vonmartins/faderbay/README.md

# FADERBAY

Current Status: Firmware not finnished. 

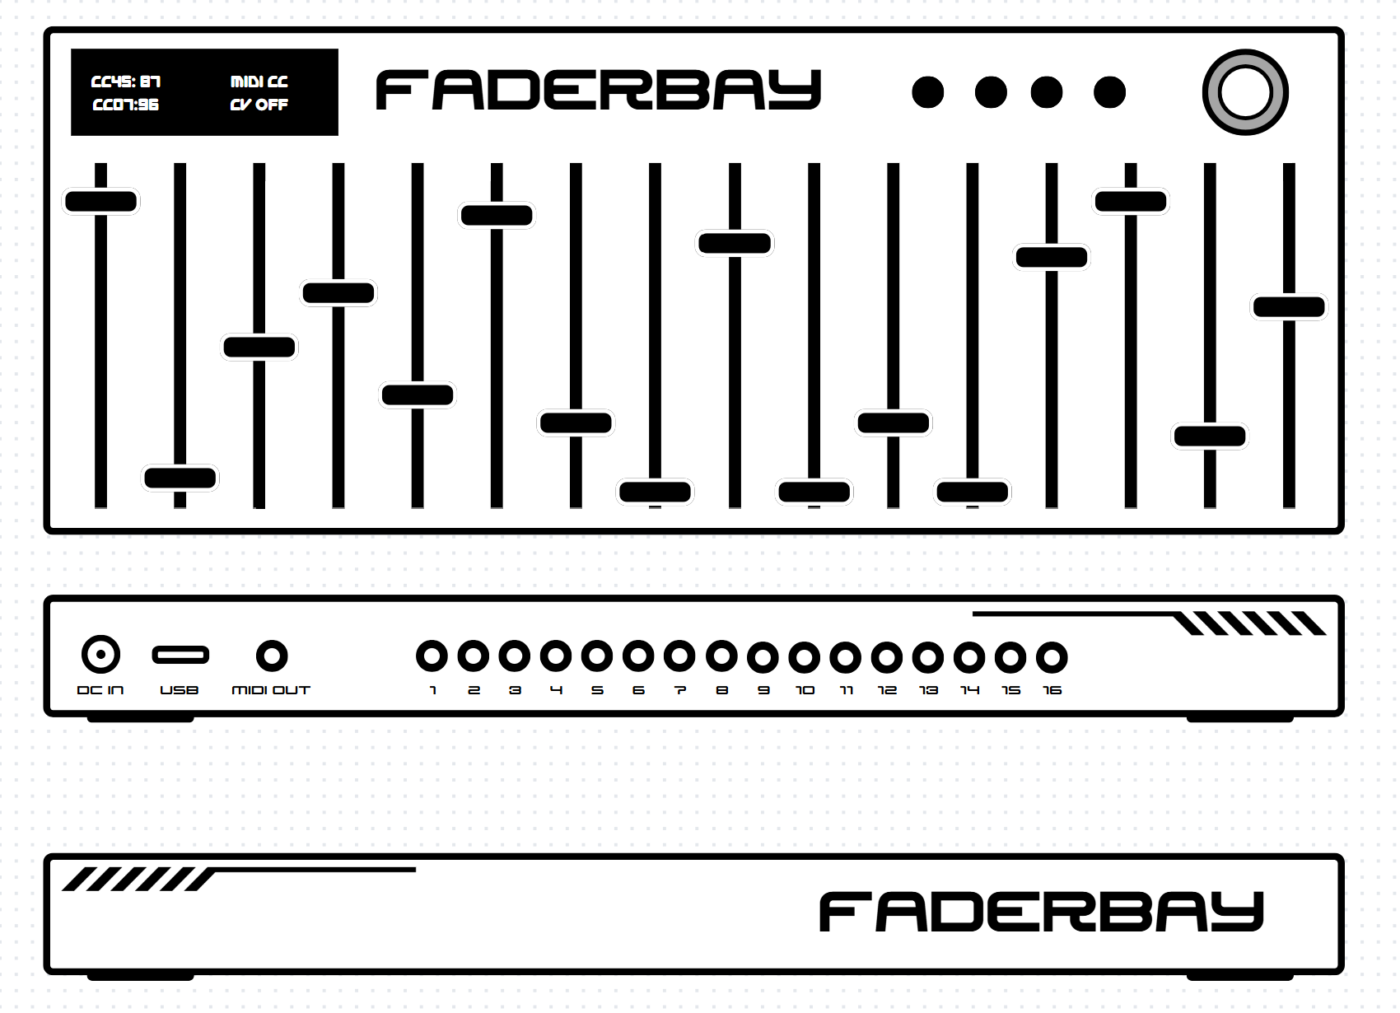
[picture p1: Images/Concept.png]
Concept


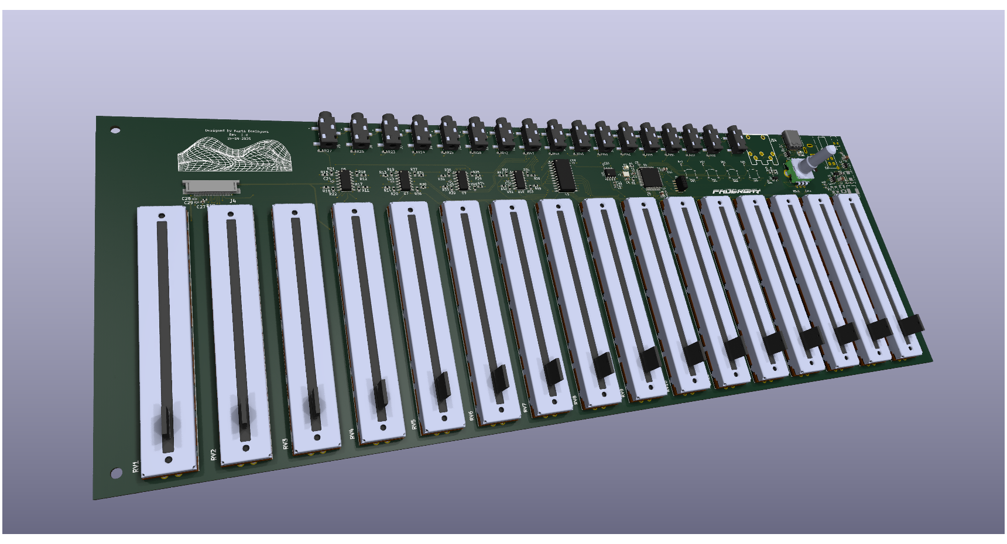
[picture p2: Images/Faderbay1.png]
im1

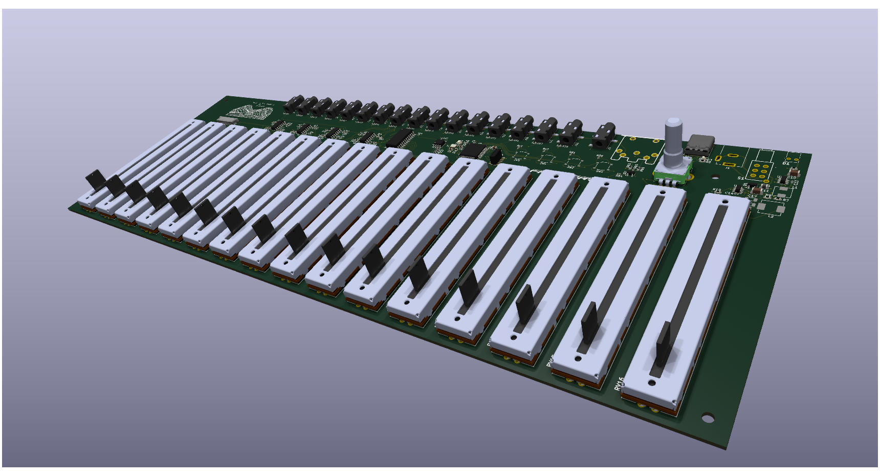
[picture p3: Images/Faderbay2.png]
im2

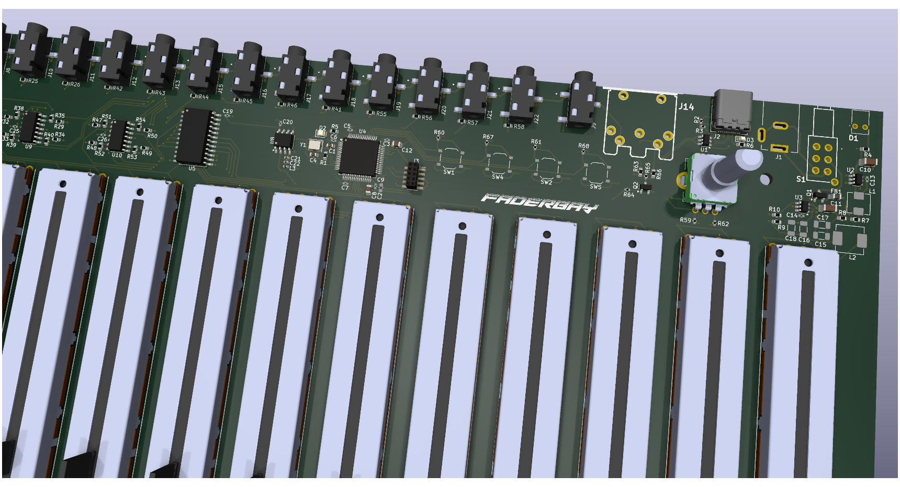
[picture p4: Images/Faderbay3.png]
im3

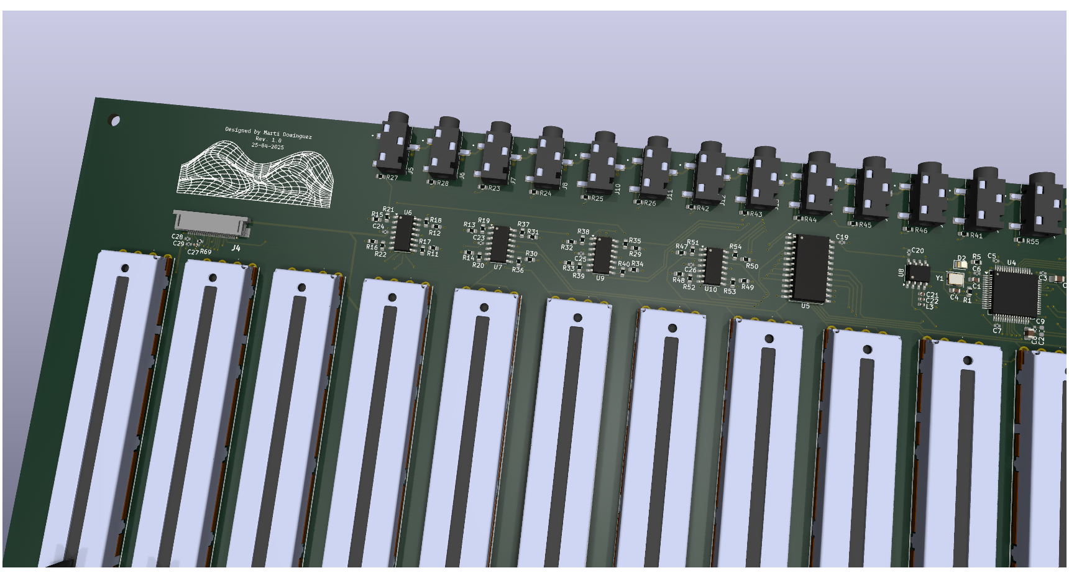
[picture p5: Images/Faderbay4.png]
im4
