vonmartins/faderbay/Legacy/Firmware/README.md

# Firmware

Currently under development.
