vonmartins/faderbay/Documentation/faderbay/resources/image_0_0.jpg

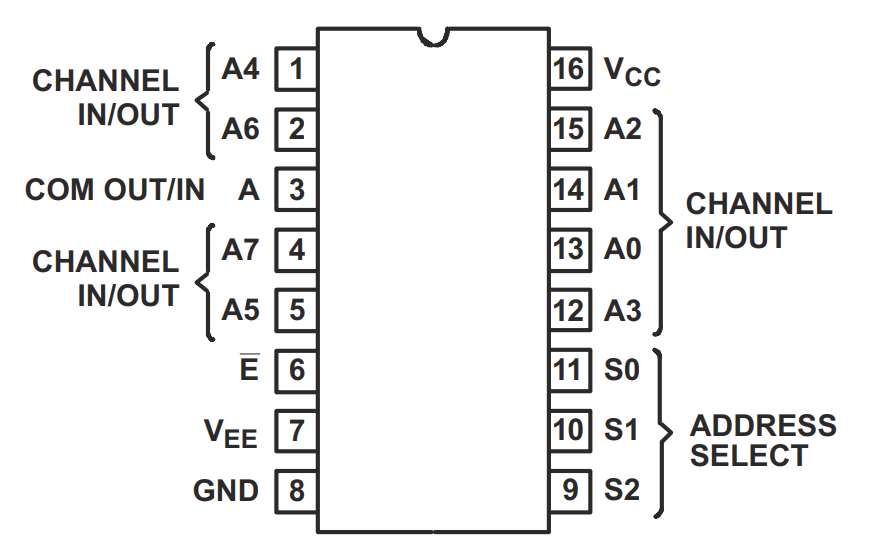
Documentation/faderbay/resources/image_0_0.jpg
