vonmartins/faderbay/Documentation/faderbay/resources/image_1418980290_0.jpg

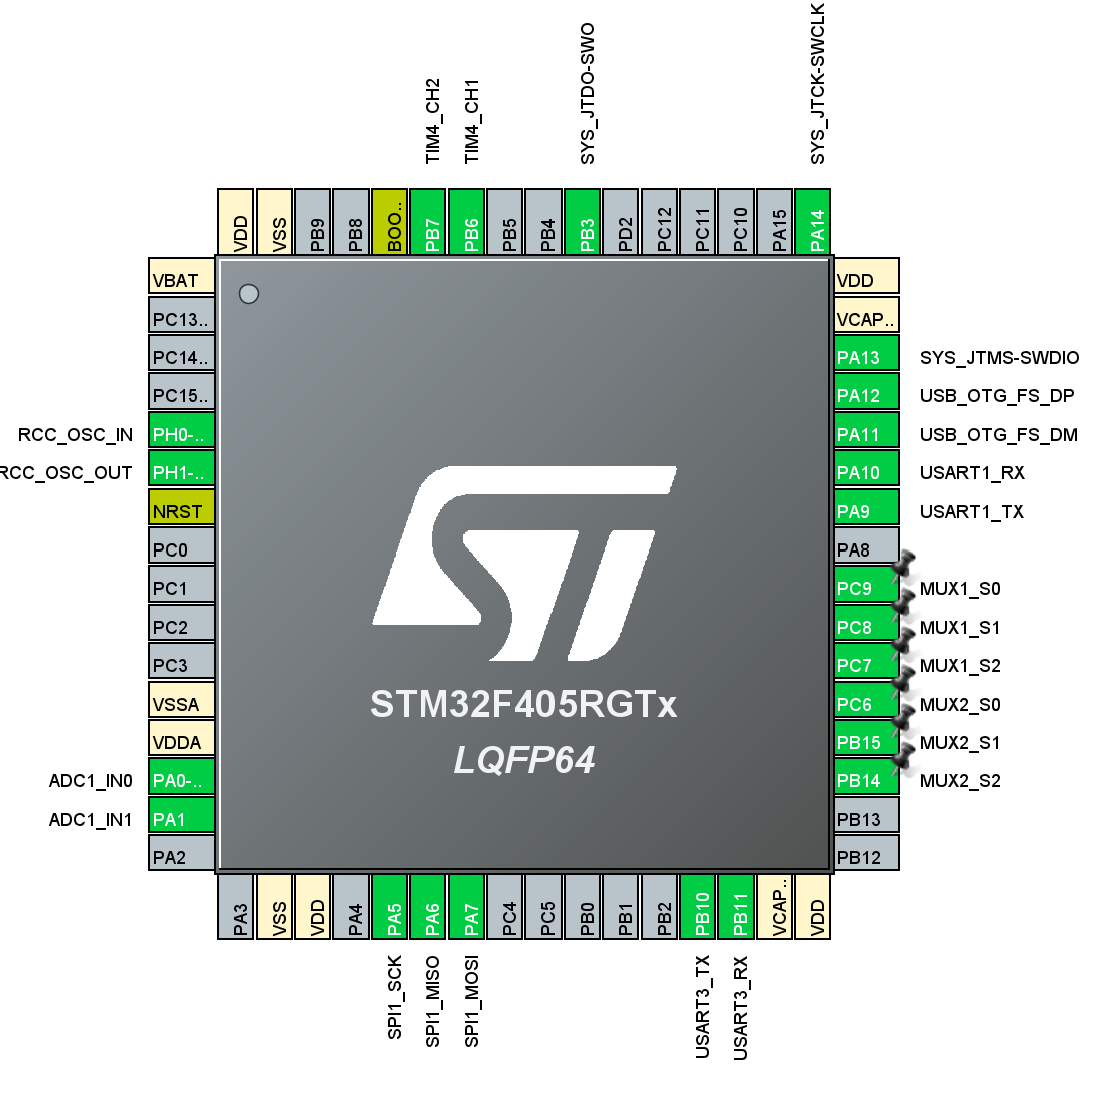
Documentation/faderbay/resources/image_1418980290_0.jpg
