vonmartins/faderbay/Images/esquema_0.png

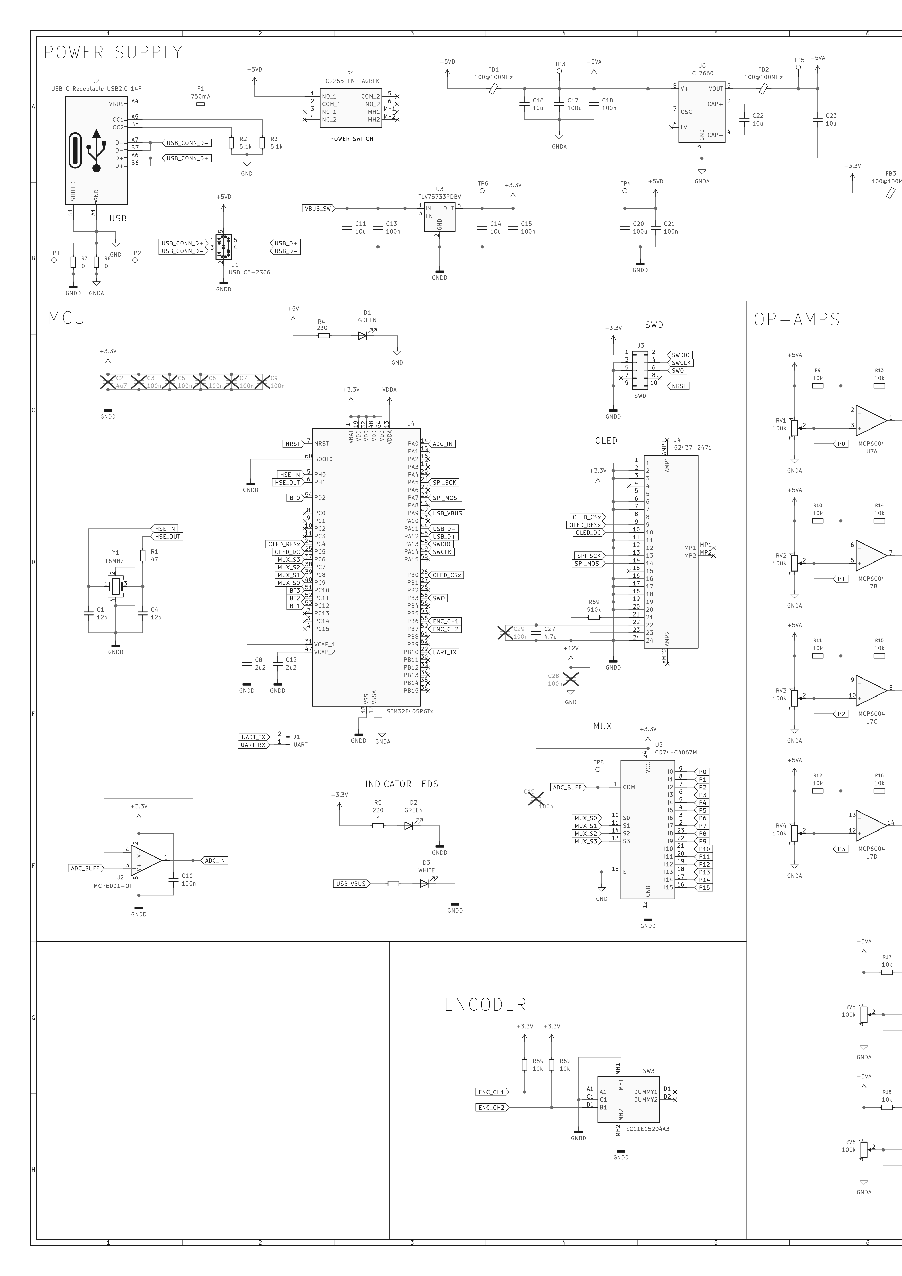
Images/esquema_0.png
