vonmartins/faderbay/Images/esquema_1.png

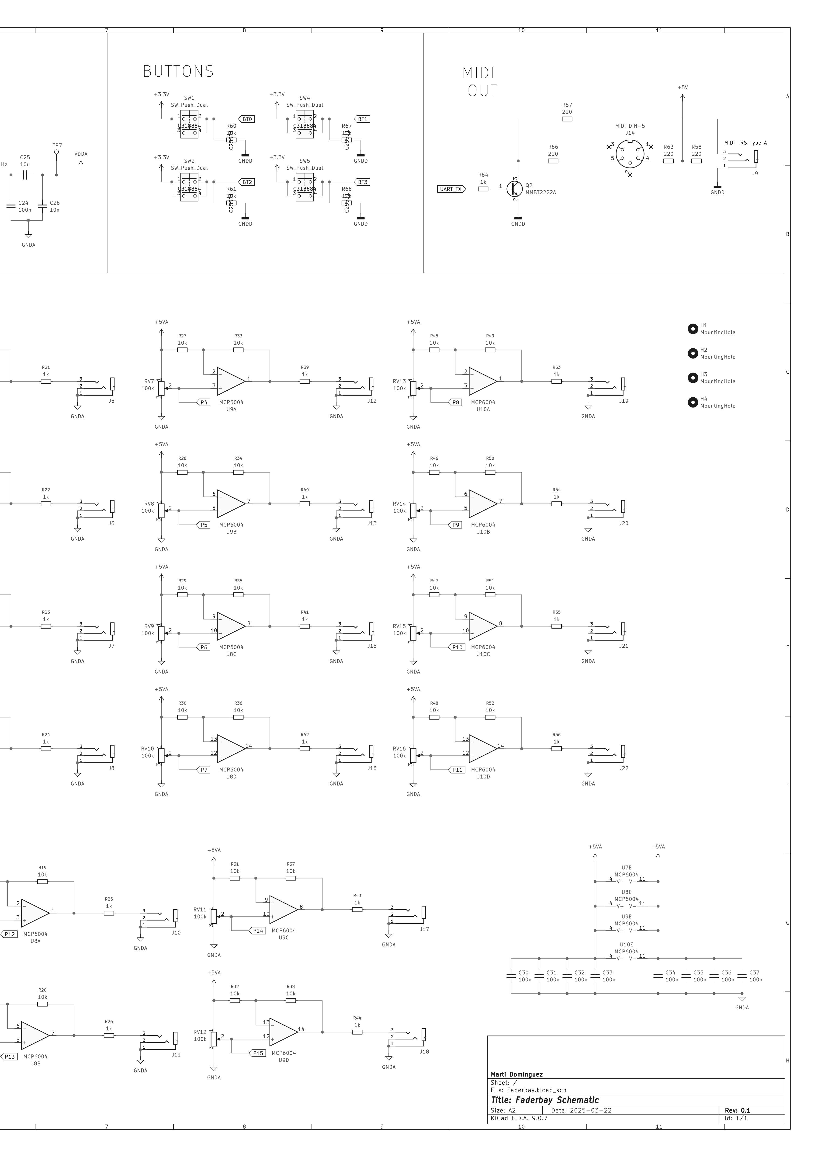
Images/esquema_1.png
