vonmartins/faderbay/Images/Gemini_Generated_Image_xs4kx1xs4kx1xs4k.png

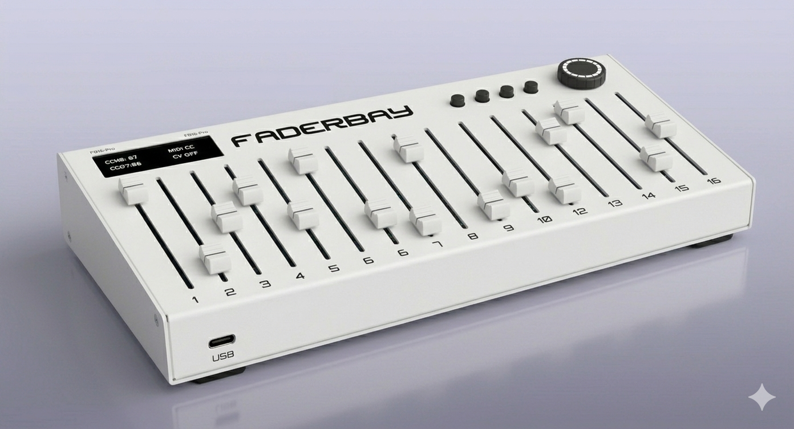
Images/Gemini_Generated_Image_xs4kx1xs4kx1xs4k.png
