vonmartins/faderbay/Images/Models.png

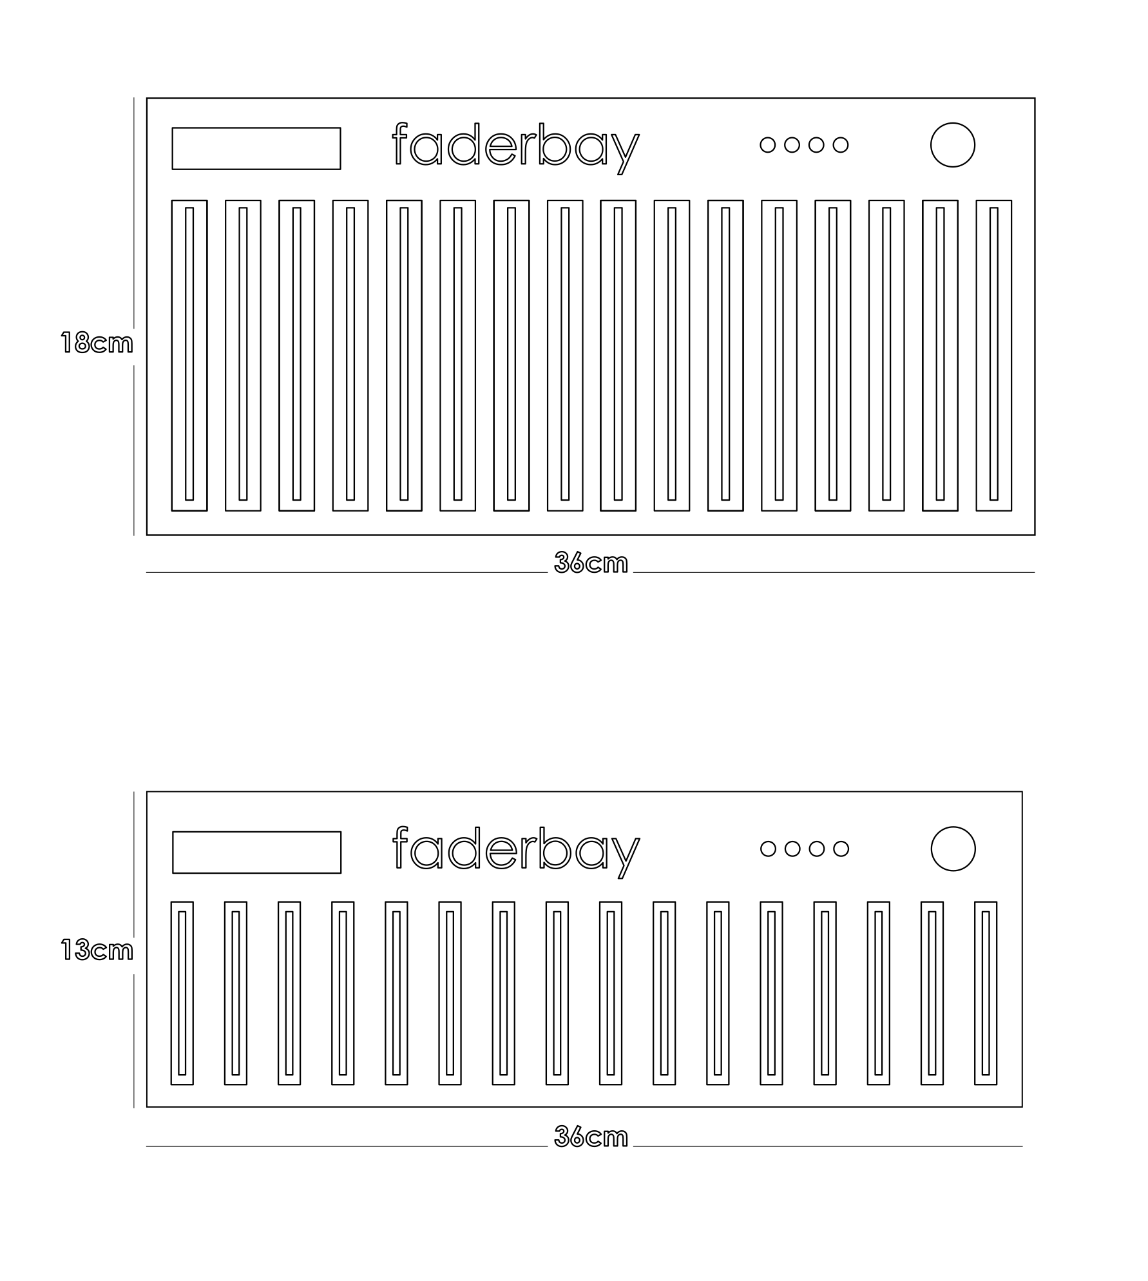
Images/Models.png
