vonmartins/faderbay/Documentation/faderbay.xlsx

Sheet: Caracteristicas
I/O
16 Faders (2MUX) | adc y gpio | MUX
4 Botones | gpio | Enh
16 Minijacks CV |  | COM
1 Minijack MIDI | uart | S0
1 USB - C | usb | S1
1 DC Input |  | S2
1 Encoder | timer
OLED Screen | spi
Midi DIN5 | uart
CARACTERISTICAS
CV Output Change Range | 0-10V and -5-5V
Save configurations | Flash
Set off/on specific CVs
Add Faders Module Expansion

Sheet: HOJA DE RUTA
HOJA DE RUTA
Descripción | Categoria | Prioridad | Estado | Progreso | Comentarios
Hacer Esquema Circuito | Hardware, Diseño | Alta | En progreso |  | EasyEDA. Mirar 16n
Mirar código EEPROM | Software | Baja | Finalizado |  | Mirar como hacer codigo para guardar en la memoria
Pensar MCU | Pensar, Hardware | Alta | Finalizado | STM32F405RGT | Que MCU usar. Con ADC. Teensy, stm32
Plantear estructura código | Software | Alta | Finalizado |  | Que librerias, estructuras, lógica general, etc
Selección de faders | Hardware, Pensar, Compra | Media | Finalizado | PTB0143-2010BPA103 | De buena calidad, lineal/log. 10 cm
Selección de pantalla OLED | Hardware, Pensar, Compra | Media | No empezado |  | I2C/SPI
Prototipo PCB | Diseño, Hardware | Baja | No empezado
Leer faders | Software | Media | En progreso |  | Uso de multiplexores
Lógica selección de modos | Software | Baja | No empezado |  | MIDI/CV/Ambos
Hacer GUI para la tft | Diseño | Baja | No empezado
Probar que resistencia ponerle al LED del fader | Hardware | Media | No empezado |  | 150, 180 o 220 ohms
start stm32cubeide project | Software | Alta | Finalizado | Hecho con VSCode
start with UI interfaces (faders, buttons, encoder) | Software | Media | En progreso
code device struct | Software | Media | En progreso
poll UI to change device settings | Software | Media | En progreso | Mirar lectura faders ya que parece que lee mal. Mapear el valor antes de comprobar si hay cambio?
Read and write memory to save configs | Software | Alta | En progreso | NO FUNCIONA. Comprobar funcion Write
MIDI Interface | Software | Media | En progreso | Comprobar | Use library? UART
MIDI Device | Software | Media | En progreso | No funciona sin oscilador de cristal o HSE? | https://github.com/Hypnotriod/midi-box-stm32/tree/master
Código OLED | Software | Media | No empezado
Implement CLI | Software | Media | Finalizado
Hacer gestion de errores | Software | Alta | Finalizado
USB Device change descriptor at cubeMX | Software | Baja | No empezado
mirar con osciloscopio si hace falta debouncing con condensadores en los botones | Hardware | Media | En progreso | Lo hago desde sfotware?
mirar osciloscopio si hacer pull up en el encoder | Hardware | Media | Finalizado | Si
Diseñar interruptor del cricuito | Hardware | Alta | En progreso |  | Se junta con el BOOT0?
Diseñar footprints faltantes | Hardware, Diseño | Alta | No empezado | Fader, encoder
Encontrar pushbutton power | Hardware | Alta | En progreso

Sheet: Copia de Hoja 2
PRODUCTO | REF | DESCRIPCIÓN | PARTE | CANTIDAD | PRECIO | TOTAL | LINK
Fader | RS6011SP6003 | 60mm / 10k |  | 16 | 4.68 € | 74.88 € | https://www.mouser.es/ProductDetail/Alps-Alpine/RS6011SP6003?qs=3cOf6TWd2rbyy41GF81woQ%3D%3D
Fader | PTL60-15O1-104B2 | 60mm / 100k |  | 16 | 2.65 € | 42.40 € | https://www.mouser.es/ProductDetail/Bourns/PTL60-15O1-104B2?qs=nAEW9fCjKd9VkMEfC2OFmQ%3D%3D
 |  |  |  |  |  | 0.00 €
Teensy 4.0 | TEENSY40 |  |  | 1 | 21.70 € | 21.70 € | https://www.pjrc.com/store/teensy40.html
Midi Conector | 485-1134 |  |  |  | 1.65 € |  | https://www.mouser.es/ProductDetail/Adafruit/1134?qs=GURawfaeGuCcC0%252BrNLxslQ%3D%3D
Multiplexor 8 ch | 74HC4051D | Multiplexor de 8 canales |  |  | 0.46 € |  | https://www.mouser.es/ProductDetail/Toshiba/74HC4051D
OP-Amp | MCP6004_SMD | Quad opamp |  |  | 0.51 € |  | https://www.mouser.es/ProductDetail/Microchip-Technology/MCP6004-I-SL?qs=n%2FfJlMG9rCZ2%2F%2FCryvZ52w%3D%3D
Mini jack hembra |  | 10 unidades |  |  | 1.66 € |  | https://m.es.aliexpress.com/item/32766726918.html
Conector USB-C | https://es.aliexpress.com/item/1005005187689195.html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
Power LED | https://www.mouser.es/ProductDetail/Kingbright/WP934EW-GD?qs=58z0TXQGVSTZ3lOkUk8wEA%3D%3D
OLED | https://newhavendisplay.com/es/3-m%C3%B3dulo-oled-gr%C3%A1fico-blanco-de-12-pulgadas/ | https://shop.lcd-module.com/search?search=W256064-XA |  |  |  | https://newhavendisplay.com/es/3-m%C3%B3dulo-oled-gr%C3%A1fico-blanco-de-12-pulgadas/
Barrel Jack DC | https://www.digikey.es/es/products/detail/kycon-inc/KLDX-0202-A/9975992?productid=9975992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
SMD LED | https://jlcpcb.com/partdetail/Xinglight-XL_1608PGC06/C7371905
USB-C Conn | https://jlcpcb.com/partdetail/AmphenolIcc-12401610E42A/C5119948
Jacks | https://jlcpcb.com/partdetail/19296-PJ_320BSurfaceMount/C18594 | https://www.mouser.es/ProductDetail/Amphenol-FCI/10038075-A1PLF?qs=LmzVcvYPptTR2f1ldRPXug%3D%3D
MIDI Conn
Inductor 0402 | https://jlcpcb.com/partdetail/Sunlord-SDCL1005C39NJTDF/C26443
Power inductor | https://jlcpcb.com/partdetail/188641-FXL0530_6R8M/C177249
Cristal OSC | X322516MLB4Sl
Mom Switch | https://www.mouser.es/ProductDetail/Wurth-Elektronik/430182070816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
Switch ON/Off | https://www.mouser.es/ProductDetail/Alpha-Taiwan/SP70030F-0202-13F1-01-NN?qs=yA6kp8fx8Y48L6RofibbJA%3D%3D

Sheet: Hoja 4
Current consumption
 | # | Voltage | Amps/unit | Total
MCU | 1 | 3v3 | 0.120 | 0.12
MUX | 1 | 3v3 | 0.008 | 0.008
MCP6004 | 4 | 3v3 | 0 | 0
Total 3.3V |  |  |  | 128 | mA
TL074 | 4 | 12 | 0.0025 | 0.01
OLED Panel | 1 | 12 | 0.055 | 0.055 | Jumper option 2 | https://newhavendisplay.com/es/3-m%C3%B3dulo-oled-gr%C3%A1fico-blanco-de-12-pulgadas/
Total 12V |  |  |  | 65 | mA
Total |  |  |  | 193 | mA
