vonmartins/faderbay/Hardware/Kicad/rev0.1/pta6043-2x10cixxxx.stp

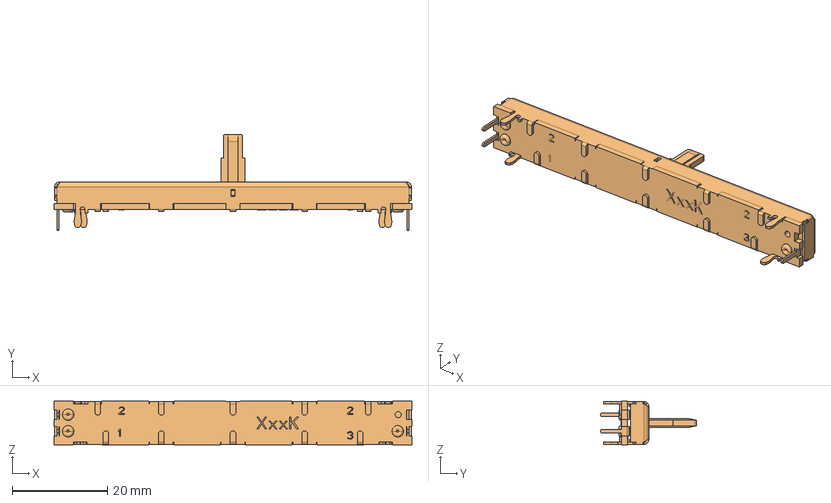
[picture p12: CAD file, 2026-05-17]
Hardware/Kicad/rev0.1/pta6043-2x10cixxxx.stp
75.2 x 20.2 x 9.20 mm
