vonmartins/faderbay/(list of files, drawings)

Other design files:
Hardware/Kicad/rev0.1/Faderbay.dsn
