vonmartins/faderbay/Hardware/Kicad/rev0.1/Faderbay.kicad_pcb

## KiCad design Hardware/Kicad/rev0.1/Faderbay.kicad_pcb (2026-05-23)

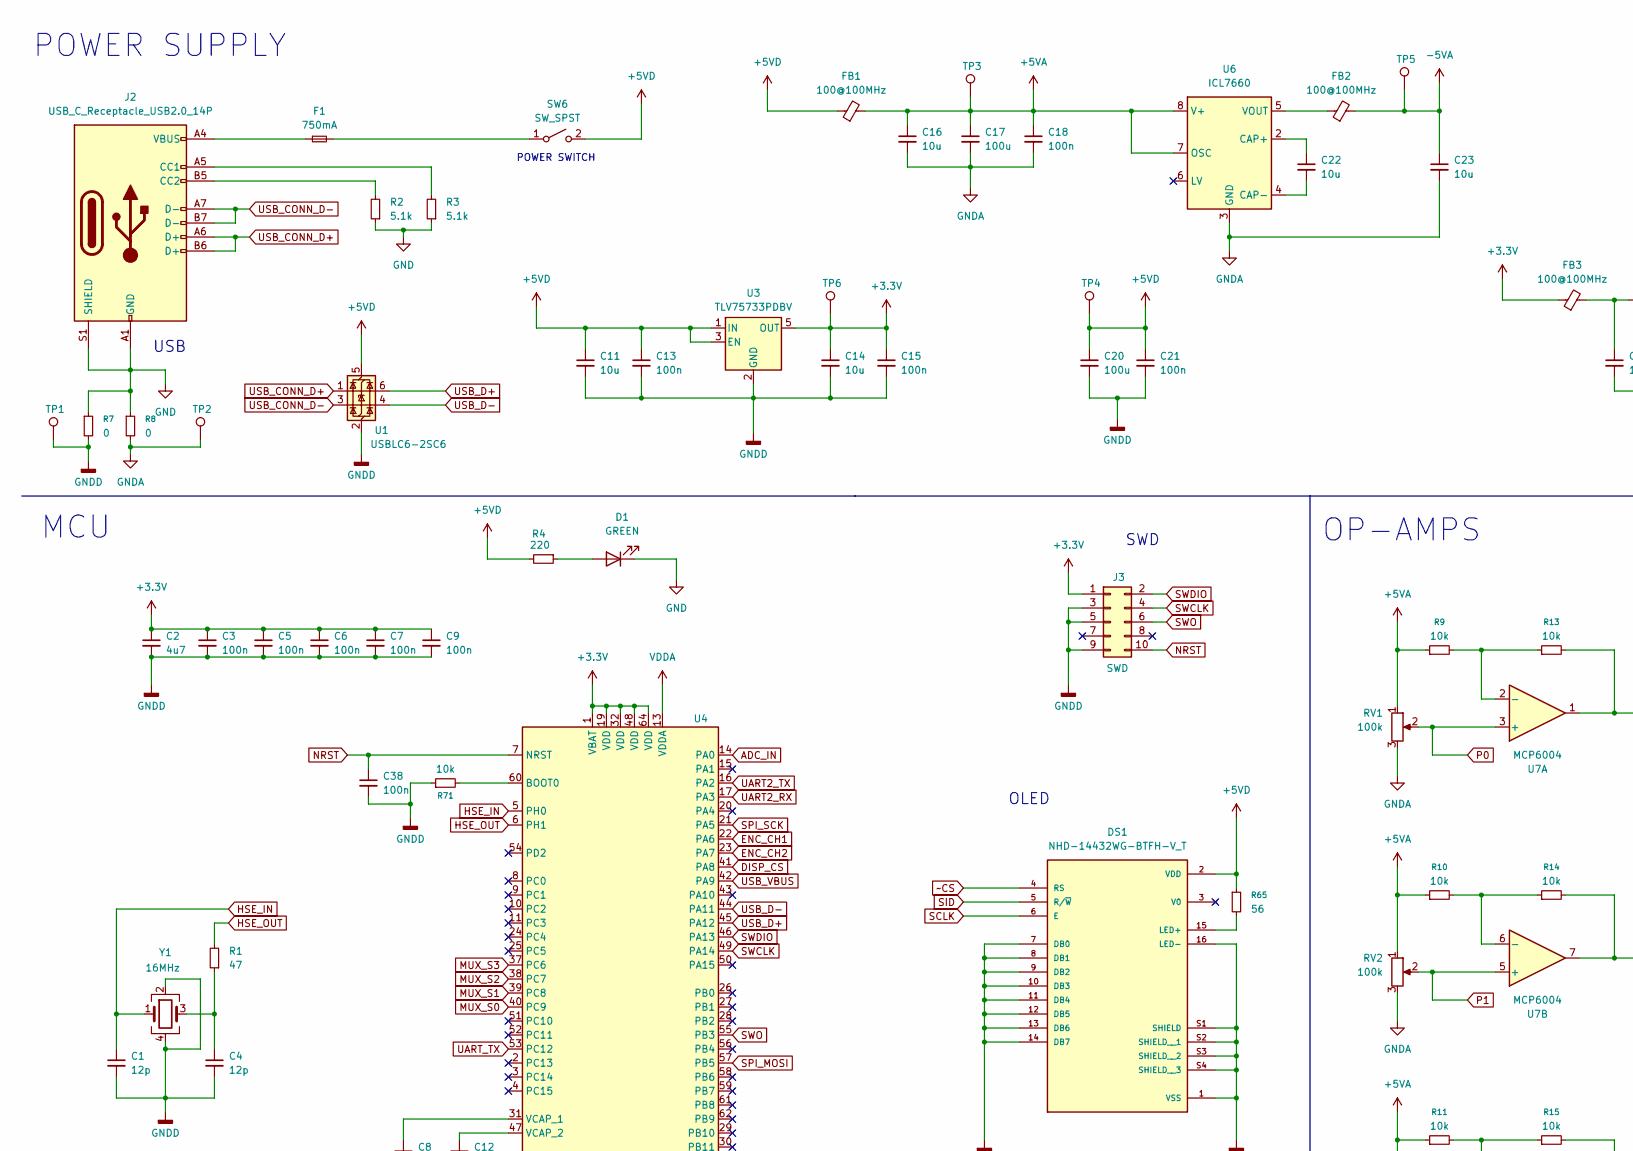
[picture p13: schematic Faderbay.kicad_sch, Faderbay Schematic, part in row 1, column 1]

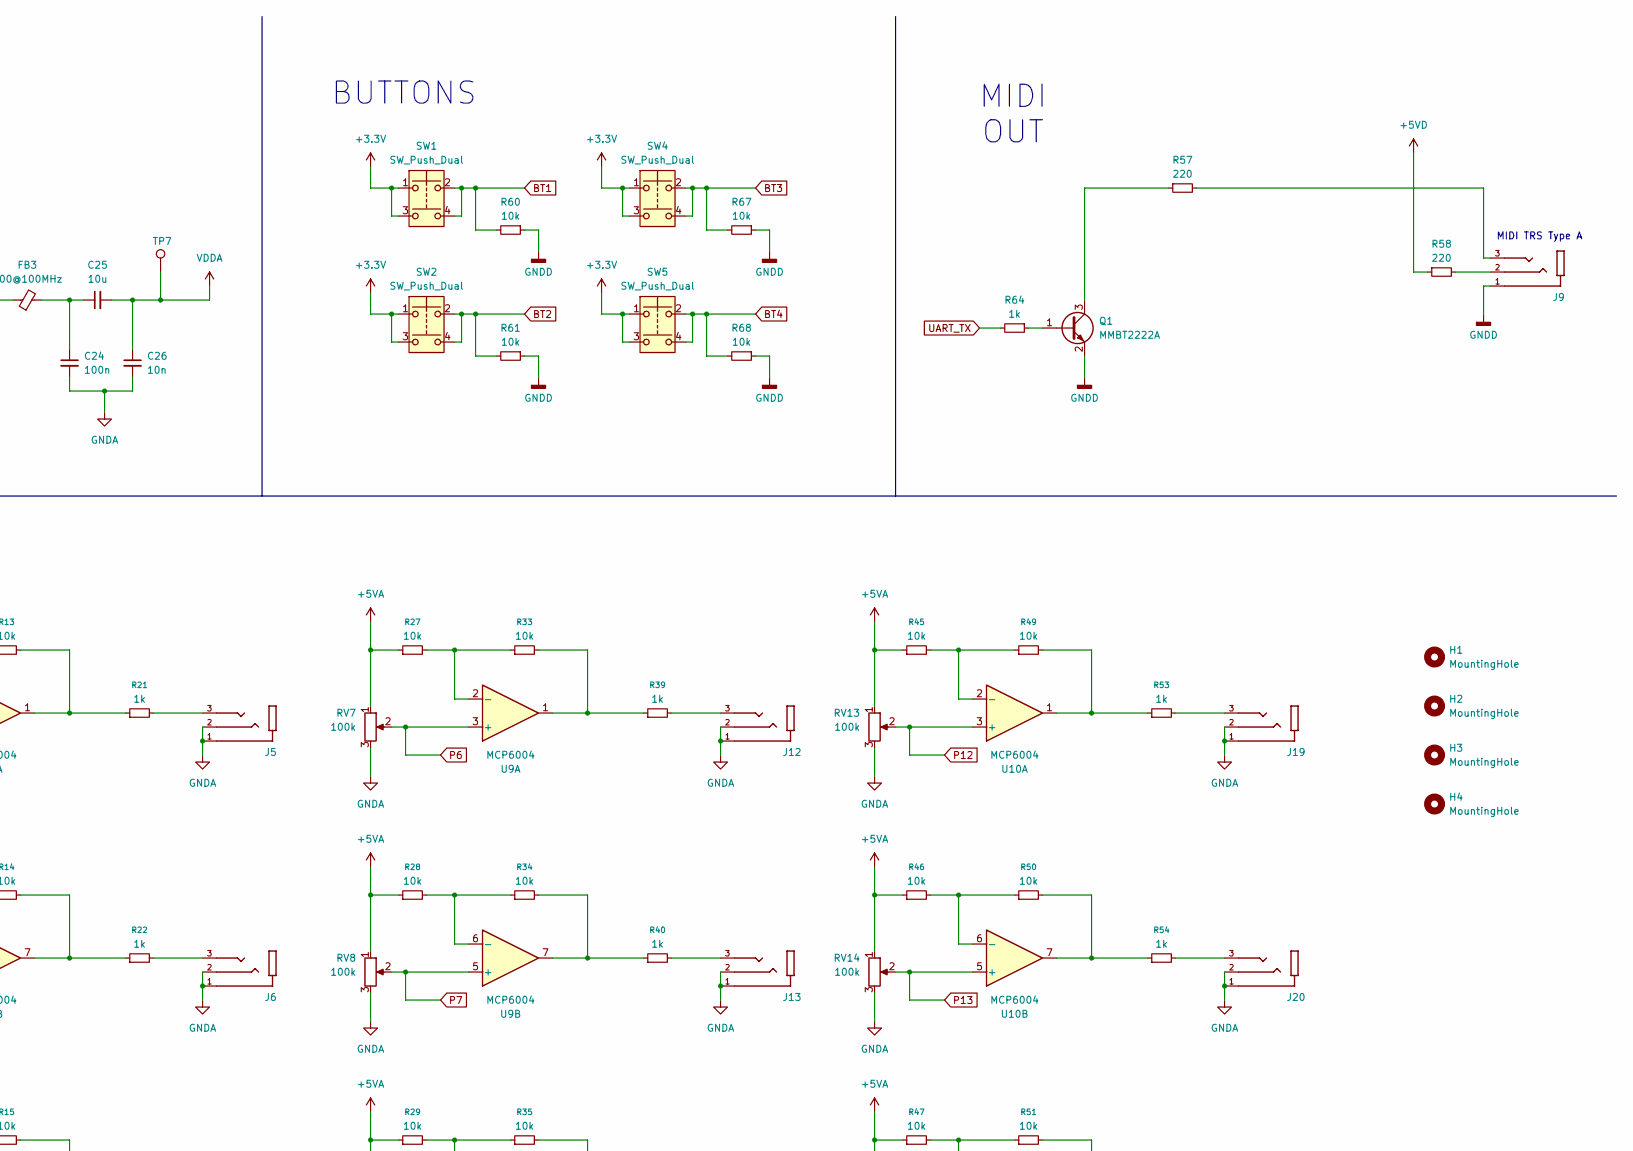
[picture p14: schematic Faderbay.kicad_sch, Faderbay Schematic, part in row 1, column 2]

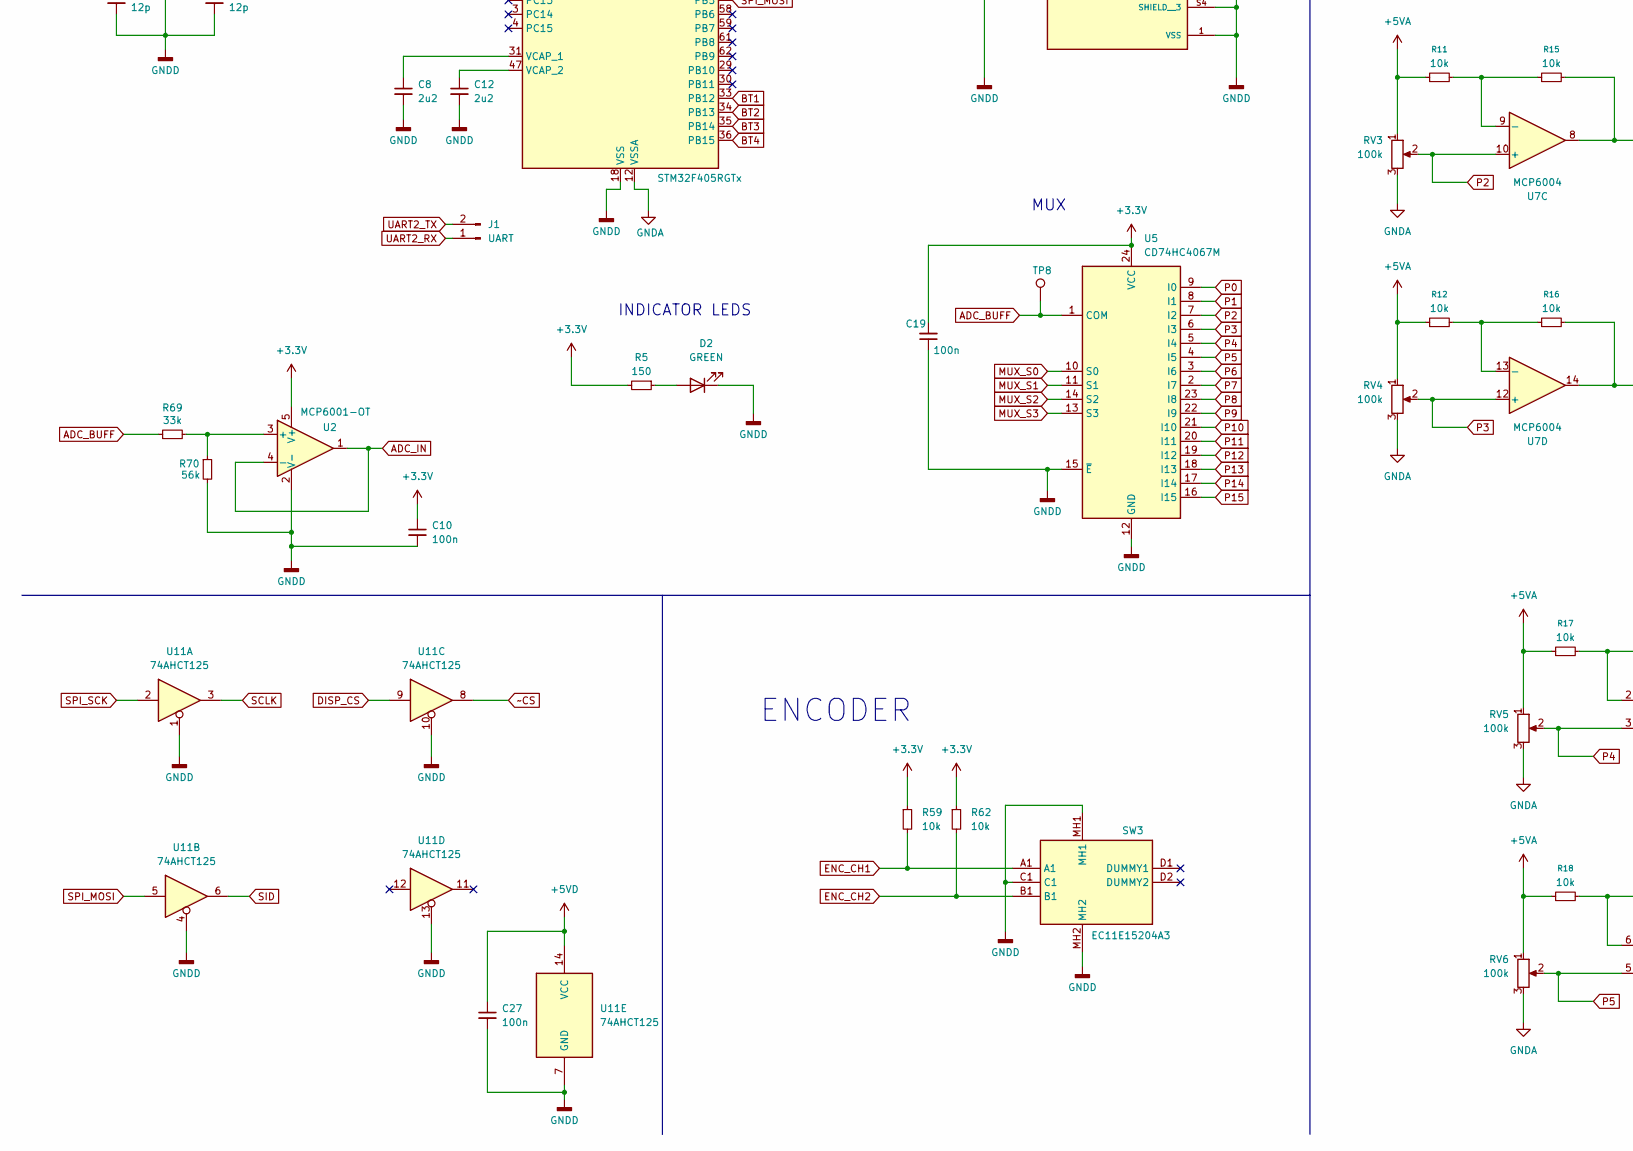
[picture p15: schematic Faderbay.kicad_sch, Faderbay Schematic, part in row 2, column 1]

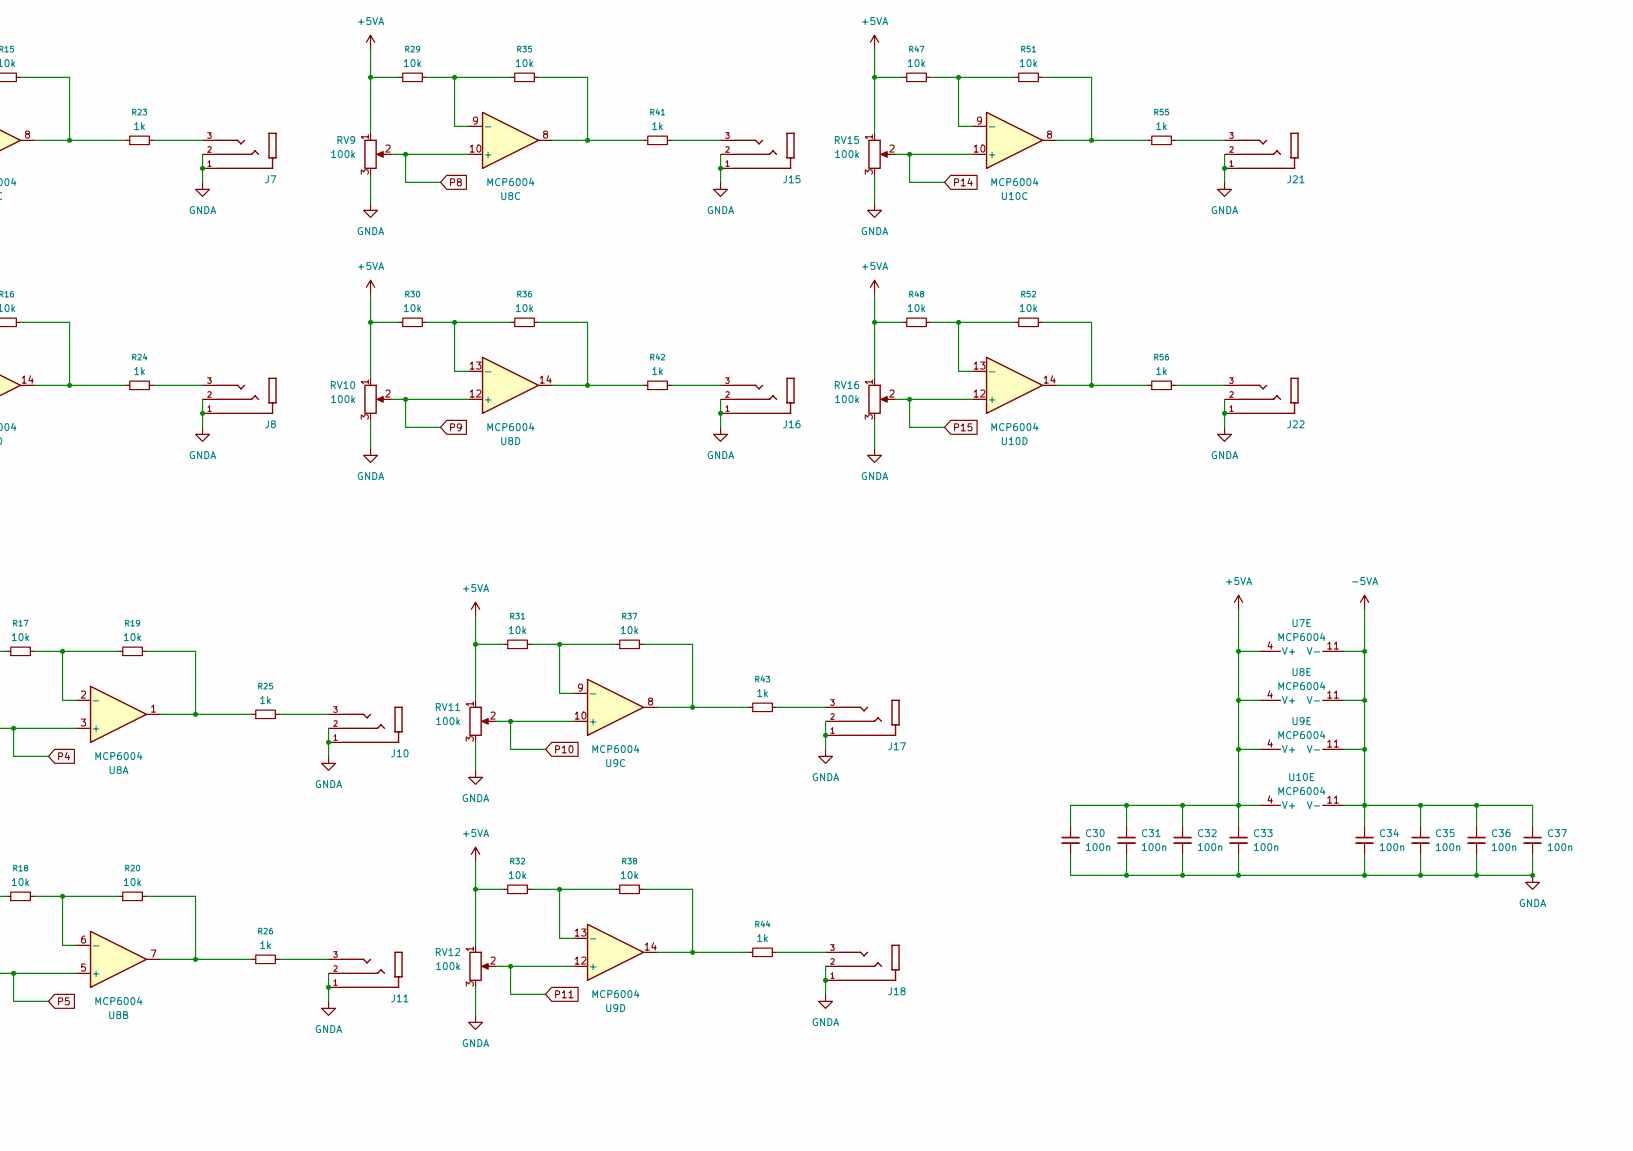
[picture p16: schematic Faderbay.kicad_sch, Faderbay Schematic, part in row 2, column 2]

Parts:
C1, C4: 12p; C_0603_1608Metric; LCSC Part # C38523
C2: 4u7; C_0805_2012Metric; LCSC Part # C19666
C3, C5, C6, C7, C9, C13, C19: 100n; C_0402_1005Metric; LCSC Part # C1525
C8, C12: 2u2; C_0805_2012Metric; LCSC Part # C377773
C10, C15, C18, C27, C30, C31, C32, C33, C34, C35, C36, C37, C38: 100n; C_0402_1005Metric
C11, C14, C16, C23: 10u; C_0805_2012Metric
C17: 100u; C_1206_3216Metric; LCSC Part # C12891
C20: 100u; C_1206_3216Metric
C21, C24: 100n; C_0402_1005Metric; LCSC Part # C52923
C22: 10u; C_1206_3216Metric
C25: 10u; C_0603_1608Metric; LCSC Part # C52923
C26: 10n; C_0402_1005Metric; LCSC Part # C52923
D1: GREEN; WP934EWGD
D2: GREEN; LED_0805_2012Metric; LCSC Part # C2297
DS1: NHD-14432WG-BTFH-V_T; LCD_NHD-14432WG-BTFH-V_T; PARTREV 9
F1: 750mA; Fuse_1206_3216Metric
FB1, FB2, FB3: 100@100MHz; L_0805_2012Metric
H1, H2, H3, H4: MountingHole; MountingHole_3.2mm_M3
J1: UART; PinHeader_1x02_P2.54mm_Vertical
J2: USB_C_Receptacle_USB2.0_14P; USB_C_Receptacle_HRO_TYPE-C-31-M-12; LCSC Part # C5119948
J3: SWD; PinSocket_2x05_P1.27mm_Vertical_SMD; LCSC Part # C350283
J5, J6, J7, J8, J9, J10, J11, J12, J13, J15, J16, J17, J18, J19, J20, J21, J22: PJ-320B; LCSC Part # C18594
Q1: MMBT2222A; SOT-23; LCSC Part # C8512
R1: 47; R_0603_1608Metric; LCSC Part # C23182
R2, R3: 5.1k; R_0402_1005Metric; LCSC Part # C23186
R4: 220; R_0603_1608Metric; LCSC Part # C23193
R5: 150; R_0603_1608Metric; LCSC Part # C17556
R7: 0; R_0603_1608Metric; LCSC Part # C25803
R8: 0; R_0603_1608Metric; LCSC Part # C22793
R9, R10, R11, R12, R13, R14, R15, R16, R17, R18, R19, R20, R27, R28, R29, R30, R31, R32, R33, R34, R35, R36, R37, R38, R45, R46, R47, R48, R49, R50, R51, R52: 10k; R_0402_1005Metric
R21, R22, R39, R40, R53, R54: 1k; R_0603_1608Metric; LCSC Part # C4184
R23, R24, R25, R26, R41, R42, R43, R44, R55, R56: 1k; R_0603_1608Metric; LCSC Part # C21190
R57, R58: 220; R_0805_2012Metric; LCSC Part # C17556
R59, R60, R61, R62, R67, R68: 10k; R_0402_1005Metric; LCSC Part # C25531
R64: 1k; R_0402_1005Metric; LCSC Part # C25531
R65: 56; R_0805_2012Metric
R69: 33k; R_0402_1005Metric
R70: 56k; R_0402_1005Metric
R71: 10k; C_0402_1005Metric
RV1, RV2, RV3, RV4, RV5, RV6, RV7, RV8, RV9, RV10, RV11, RV12, RV13, RV14, RV15, RV16: 100k; Potentiometer_Bourns_PTA6043_Single_Slide
SW1, SW2, SW4, SW5: SW_Push_Dual; 430182070816; LCSC Part # C318884
SW3: EC11E15204A3; Mouser Part Number 688-EC11E15204A3
SW6: SW_SPST; RA1H1C112R
TP1, TP2, TP3, TP4, TP5, TP6, TP7, TP8: TestPoint; TestPoint_Loop_D2.50mm_Drill1.0mm
U1: USBLC6-2SC6; SOT-23-6; LCSC Part # C7519
U2: MCP6001-OT; SOT-23-5
U3: TLV75733PDBV; SOT-23-5
U4: STM32F405RGTx; LQFP-64_10x10mm_P0.5mm; LCSC Part # C15742
U5: CD74HC4067M; SOIC-24W_7.5x15.4mm_P1.27mm; LCSC Part # C496123
U6: ICL7660; SOIC-8_3.9x4.9mm_P1.27mm
U7, U8, U9, U10: MCP6004; TSSOP-14_4.4x5mm_P0.65mm
U11: 74AHCT125; SOIC-14_3.9x8.7mm_P1.27mm
Y1: 16MHz; Crystal_SMD_3225-4Pin_3.2x2.5mm; LCSC Part # C13738

Connections:
+3.3V: C2.1, C3.1, C5.1, C6.1, C7.1, C9.1, C10.1, C14.1, C15.1, C19.2, FB3.1, J3.1, R5.2, R59.1, R62.1, SW1.1, SW1.3, SW2.1, SW2.3, SW4.1, SW4.3, SW5.1, SW5.3, TP6.1 (1_1), U2.5 (V+), U3.5 (OUT), U4.1 (VBAT), U4.19 (VDD), U4.32 (VDD), U4.48 (VDD), U4.64 (VDD), U5.24 (VCC)
+5VA: C16.1, C17.1, C18.1, C30.1, C31.1, C32.1, C33.1, FB1.2, R9.1, R10.1, R11.1, R12.1, R17.1, R18.1, R27.1, R28.1, R29.1, R30.1, R31.1, R32.1, R45.1, R46.1, R47.1, R48.1, RV1.1, RV2.1, RV3.1, RV4.1, RV5.1, RV6.1, RV7.1, RV8.1, RV9.1, RV10.1, RV11.1, RV12.1, RV13.1, RV14.1, RV15.1, RV16.1, TP3.1 (1_1), U6.7 (OSC), U6.8 (V+), U7.4 (V+), U8.4 (V+), U9.4 (V+), U10.4 (V+)
+5VD: C11.1, C13.1, C20.1, C21.1, C27.1, DS1.2 (VDD), FB1.1, R4.2, R58.1, R65.1, SW6.2 (B), TP4.1 (1_1), U1.5 (VBUS), U3.1 (IN), U3.3 (EN), U11.14 (VCC)
-5VA: C23.1, C34.1, C35.1, C36.1, C37.1, FB2.2, TP5.1 (1_1), U7.11 (V-), U8.11 (V-), U9.11 (V-), U10.11 (V-)
ADC_BUFF: R69.1, TP8.1 (1_1), U5.1 (COM)
ADC_IN: U2.1, U2.4 (-), U4.14 (PA0)
BT1: R60.2, SW1.2, SW1.4, U4.33 (PB12)
BT2: R61.2, SW2.2, SW2.4, U4.34 (PB13)
BT3: R67.2, SW4.2, SW4.4, U4.35 (PB14)
BT4: R68.2, SW5.2, SW5.4, U4.36 (PB15)
DISP_CS: U4.41 (PA8), U11.9
ENC_CH1: R59.2, SW3.A1, U4.22 (PA6)
ENC_CH2: R62.2, SW3.B1, U4.23 (PA7)
GND: D1.1 (K), J2.A1 (GND), J2.A12 (GND), J2.B1 (GND), J2.B12 (GND), J2.S1 (SHIELD), R2.1, R3.1, R7.1, R8.1
GNDA: C16.2, C17.2, C18.2, C23.2, C24.2, C26.2, C30.2, C31.2, C32.2, C33.2, C34.2, C35.2, C36.2, C37.2, J5.1, J5.2, J6.1, J6.2, J7.1, J7.2, J8.1, J8.2, J10.1, J10.2, J11.1, J11.2, J12.1, J12.2, J13.1, J13.2, J15.1, J15.2, J16.1, J16.2, J17.1, J17.2, J18.1, J18.2, J19.1, J19.2, J20.1, J20.2, J21.1, J21.2, J22.1, J22.2, R8.2, RV1.3, RV2.3, RV3.3, RV4.3, RV5.3, RV6.3, RV7.3, RV8.3, RV9.3, RV10.3, RV11.3, RV12.3, RV13.3, RV14.3, RV15.3, RV16.3, TP2.1 (1_1), U4.12 (VSSA), U6.3 (GND)
GNDD: C1.2, C2.2, C3.2, C4.2, C5.2, C6.2, C7.2, C8.2, C9.2, C10.2, C11.2, C12.2, C13.2, C14.2, C15.2, C19.1, C20.2, C21.2, C27.2, C38.2, D2.1 (K), DS1.1 (VSS), DS1.7 (DB0), DS1.8 (DB1), DS1.9 (DB2), DS1.10 (DB3), DS1.11 (DB4), DS1.12 (DB5), DS1.13 (DB6), DS1.14 (DB7), DS1.16 (LED-), DS1.S1 (SHIELD), DS1.S2 (SHIELD__1), DS1.S3 (SHIELD__2), DS1.S4 (SHIELD__3), J3.3, J3.5, J3.9, J9.1, Q1.2 (E), R7.2, R60.1, R61.1, R67.1, R68.1, R70.2, R71.1, SW3.C1, SW3.MH1, SW3.MH2, TP1.1 (1_1), U1.2 (GND), U2.2 (V-), U3.2 (GND), U4.18 (VSS), U4.63 (VSS), U5.12 (GND), U5.15 (~E), U11.1, U11.4, U11.7 (GND), U11.10, U11.13, Y1.2, Y1.4
HSE_IN: C1.1, U4.5 (PH0), Y1.1
HSE_OUT: R1.2, U4.6 (PH1)
MUX_S0: U4.40 (PC9), U5.10 (S0)
MUX_S1: U4.39 (PC8), U5.11 (S1)
MUX_S2: U4.38 (PC7), U5.14 (S2)
MUX_S3: U4.37 (PC6), U5.13 (S3)
NRST: C38.1, J3.10, U4.7 (NRST)
unnamed: C4.1, R1.1, Y1.3
unnamed: C24.1, C25.1, FB3.2
unnamed: D1.2 (A), R4.1
unnamed: D2.2 (A), R5.1
unnamed: DS1.15 (LED+), R65.2
unnamed: F1.1, J2.A4 (VBUS), J2.A9 (VBUS), J2.B4 (VBUS), J2.B9 (VBUS)
unnamed: J2.A5 (CC1), R3.2
unnamed: J2.B5 (CC2), R2.2
unnamed: J5.3, R21.2
unnamed: J6.3, R22.2
unnamed: J7.3, R23.2
unnamed: J8.3, R24.2
unnamed: J9.2, R58.2
unnamed: J9.3, R57.2
unnamed: J10.3, R25.2
unnamed: J11.3, R26.2
unnamed: J12.3, R39.2
unnamed: J13.3, R40.2
unnamed: J15.3, R41.2
unnamed: J16.3, R42.2
unnamed: J17.3, R43.2
unnamed: J18.3, R44.2
unnamed: J19.3, R53.2
unnamed: J20.3, R54.2
unnamed: J21.3, R55.2
unnamed: J22.3, R56.2
unnamed: Q1.1 (B), R64.1
unnamed: Q1.3 (C), R57.1
unnamed: R13.2, R21.1, U7.1
unnamed: R14.2, R22.1, U7.7
unnamed: R15.2, R23.1, U7.8
unnamed: R16.2, R24.1, U7.14
unnamed: R19.2, R25.1, U8.1
unnamed: R20.2, R26.1, U8.7
unnamed: R33.2, R39.1, U9.1
unnamed: R34.2, R40.1, U9.7
unnamed: R35.2, R41.1, U8.8
unnamed: R36.2, R42.1, U8.14
unnamed: R37.2, R43.1, U9.8
unnamed: R38.2, R44.1, U9.14
unnamed: R49.2, R53.1, U10.1
unnamed: R50.2, R54.1, U10.7
unnamed: R51.2, R55.1, U10.8
unnamed: R52.2, R56.1, U10.14
unnamed: F1.2, SW6.1 (A)
unnamed: R69.2, R70.1, U2.3 (+)
unnamed: R71.2, U4.60 (BOOT0)
unnamed: C8.1, U4.31 (VCAP_1)
unnamed: C12.1, U4.47 (VCAP_2)
unnamed: C22.1, U6.2 (CAP+)
unnamed: C22.2, U6.4 (CAP-)
unnamed: FB2.1, U6.5 (VOUT)
unnamed: R9.2, R13.1, U7.2 (-)
unnamed: R10.2, R14.1, U7.6 (-)
unnamed: R11.2, R15.1, U7.9 (-)
unnamed: R12.2, R16.1, U7.13 (-)
unnamed: R17.2, R19.1, U8.2 (-)
unnamed: R18.2, R20.1, U8.6 (-)
unnamed: R29.2, R35.1, U8.9 (-)
unnamed: R30.2, R36.1, U8.13 (-)
unnamed: R27.2, R33.1, U9.2 (-)
unnamed: R28.2, R34.1, U9.6 (-)
unnamed: R31.2, R37.1, U9.9 (-)
unnamed: R32.2, R38.1, U9.13 (-)
unnamed: R45.2, R49.1, U10.2 (-)
unnamed: R46.2, R50.1, U10.6 (-)
unnamed: R47.2, R51.1, U10.9 (-)
unnamed: R48.2, R52.1, U10.13 (-)
P0: RV1.2, U5.9 (I0), U7.3 (+)
P1: RV2.2, U5.8 (I1), U7.5 (+)
P2: RV3.2, U5.7 (I2), U7.10 (+)
P3: RV4.2, U5.6 (I3), U7.12 (+)
P4: RV5.2, U5.5 (I4), U8.3 (+)
P5: RV6.2, U5.4 (I5), U8.5 (+)
P6: RV7.2, U5.3 (I6), U9.3 (+)
P7: RV8.2, U5.2 (I7), U9.5 (+)
P8: RV9.2, U5.23 (I8), U8.10 (+)
P9: RV10.2, U5.22 (I9), U8.12 (+)
P10: RV11.2, U5.21 (I10), U9.10 (+)
P11: RV12.2, U5.20 (I11), U9.12 (+)
P12: RV13.2, U5.19 (I12), U10.3 (+)
P13: RV14.2, U5.18 (I13), U10.5 (+)
P14: RV15.2, U5.17 (I14), U10.10 (+)
P15: RV16.2, U5.16 (I15), U10.12 (+)
SCLK: DS1.6 (E), U11.3
SID: DS1.5 (R/~W), U11.6
SPI_MOSI: U4.57 (PB5), U11.5
SPI_SCK: U4.21 (PA5), U11.2
SWCLK: J3.4, U4.49 (PA14)
SWDIO: J3.2, U4.46 (PA13)
SWO: J3.6, U4.55 (PB3)
UART2_RX: J1.1, U4.17 (PA3)
UART2_TX: J1.2, U4.16 (PA2)
UART_TX: R64.2, U4.53 (PC12)
USB_CONN_D+: J2.A6 (D+), J2.B6 (D+), U1.1 (I/O1)
USB_CONN_D-: J2.A7 (D-), J2.B7 (D-), U1.3 (I/O2)
USB_D+: U1.6 (I/O1), U4.45 (PA12)
USB_D-: U1.4 (I/O2), U4.44 (PA11)
USB_VBUS: U4.42 (PA9)
VDDA: C25.2, C26.1, TP7.1 (1_1), U4.13 (VDDA)
~CS: DS1.4 (RS), U11.8

Notes on the sheet:
BUTTONS
MIDI OUT
MCU
USB
MUX
MIDI TRS Type A
POWER SWITCH
INDICATOR LEDS
POWER SUPPLY
SWD
OLED
ENCODER
OP-AMPS

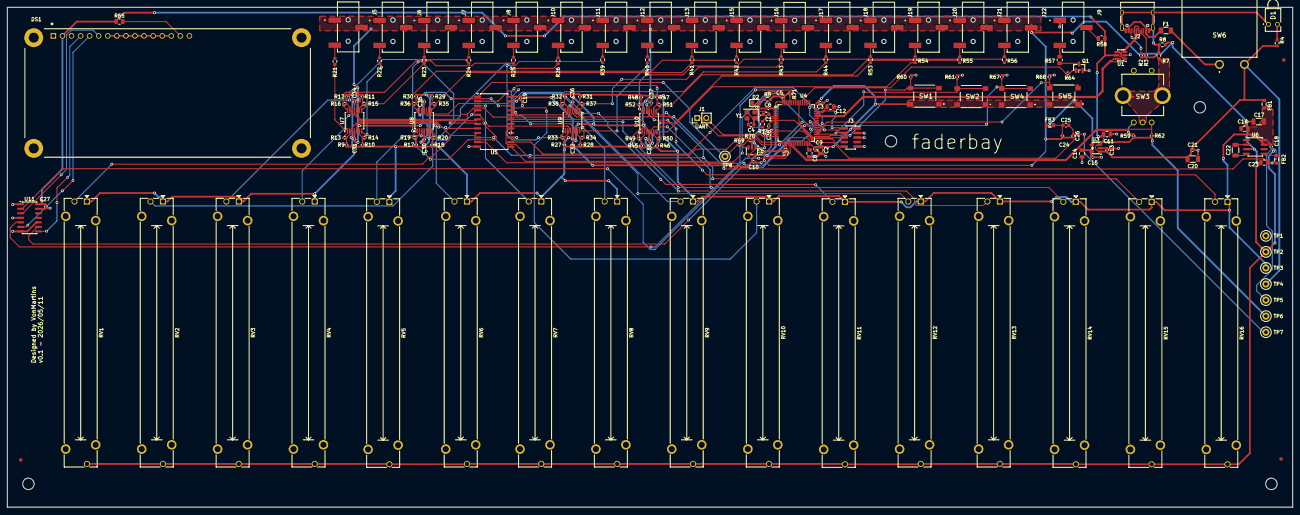
[picture p17: board Faderbay.kicad_pcb from above]

Board: 4 copper layers, 360.0 x 140.0 mm, 181 parts (0 on the bottom side), 123 nets.

Other parts of the board:
FID1, FID2, FID3: Fiducial_1mm_Mask2mm
