vonmartins/faderbay/Legacy/Firmware/Core/Src/main.c

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
/* Includes ------------------------------------------------------------------*/
#include "main.h"

/* USER CODE BEGIN Includes */
//#include "device.h"
#include "device.h"
#include "string.h"
#include "cli_fns.h"
#include "device_def.h"
/* USER CODE END Includes */

ADC_HandleTypeDef hadc1;

TIM_HandleTypeDef htim2;

UART_HandleTypeDef huart1;
UART_HandleTypeDef huart2;

/* USER CODE BEGIN PV */
Device_t device;
cli_t cli; 
uint8_t rx_buffer;
Flash_Write_Block_t device_config_block;
/* USER CODE END PV */

void SystemClock_Config(void);
static void MX_GPIO_Init(void);
static void MX_ADC1_Init(void);
static void MX_TIM2_Init(void);
static void MX_USART1_UART_Init(void);
static void MX_USART2_UART_Init(void);
/* USER CODE BEGIN PFP */
void Device_Init(Device_t *device);
void Device_Update(Device_t *device);
void user_uart_println(char *string);
device_error_t CLI_init();
/* USER CODE END PFP */

/**
  * @brief  The application entry point.
  * @retval int
  */
int main(void)
{

  /* MCU Configuration--------------------------------------------------------*/

  /* Reset of all peripherals, Initializes the Flash interface and the Systick. */
  HAL_Init();

  /* Configure the system clock */
  SystemClock_Config();

  /* Initialize all configured peripherals */
  MX_GPIO_Init();
  MX_ADC1_Init();
  MX_TIM2_Init();
  MX_USART1_UART_Init();
  MX_USART2_UART_Init();
  /* USER CODE BEGIN 2 */
  Device_Init(&device);
  /* USER CODE END 2 */

  /* Infinite loop */
  /* USER CODE BEGIN WHILE */
  while (1)
  {
    /* USER CODE END WHILE */

    /* USER CODE BEGIN 3 */
    Device_Update(&device);
    #ifdef USE_CLI
      cli_process(&cli);
    #endif
  }
  /* USER CODE END 3 */
}

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
/* USER CODE BEGIN 4 */
void Device_Init(Device_t *device)
{
  device->midi_handle = &huart1;

  /* UI Init */
  DEVICE_PROCESS(UI_Init(&device->UI));
  device->current_preset = 1;
  device->midi_to_send = 0;

  /* Reading from Flash */
  Flash_Read_Configs(&device_config_block);
  if (Is_First_Initialization())
  {
    Set_Config_Default(&device->current_config);
    Init_Presets();
  } else {
    memcpy(device->presets, device_config_block.current_presets, sizeof(device_config_block.current_presets));
    memcpy(&device->current_config, &device_config_block.current_config, sizeof(device_config_block.current_config));
  }
  #ifdef USE_CLI
    CLI_init();
  #endif

  PRINT("-------------- DEVICE INITIALIZED --------------\r\n");
  
}

void Device_Update(Device_t *device)
{
  UI_Poll(&device->UI);
  // TO DO: Oled_Update();
  DEVICE_PROCESS(Midi_Update());
}

void user_uart_println(char *string)
{
  DEVICE_PROCESS(HAL_UART_Transmit(&huart2, (uint8_t *)string, strlen(string), HAL_MAX_DELAY));
}

void HAL_UART_RxCpltCallback(UART_HandleTypeDef *huart) {
  if (huart->Instance == USART2) { 
      cli_put(&cli, rx_buffer);  
      HAL_UART_Receive_IT(&huart2, &rx_buffer, 1); 
  }
}

device_error_t CLI_init()
{
  cli_status_t rslt = CLI_OK;
  cli.cmd_tbl = cmd_tbl;
  cli.cmd_cnt = sizeof(cmd_tbl) / sizeof(cmd_t);
  cli.println = user_uart_println;
  if((rslt = cli_init(&cli)) != CLI_OK)
  {
    user_uart_println("[ERROR]: CLI failed to initialise\r\n");
    return DEVICE_CLI_ERROR;
  } else {
    PRINT("CLI Initialised\r\n");
  }
  HAL_UART_Receive_IT(&huart2, &rx_buffer, 1);
  return DEVICE_OK;
}

int _write(int file, char *ptr, int len)
{
    HAL_UART_Transmit(&huart2, (uint8_t*)ptr, len, HAL_MAX_DELAY);
    return len;
}


/* USER CODE END 4 */
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
