vonmartins/faderbay/(commit log)

2025-03-08 Track Config Files
2025-03-08 Refactor UI and device structures; add configuration handling and initialization logic
2025-03-08 Fix header guard naming convention in button.h
    [button.h]
2025-03-08 Add UI mode and editing functionality to device management
2025-03-08 Rename button defines for improved clarity and functionality
2025-03-10 Add Init_Presets function to initialize device presets
2025-03-13 Add MIDI Device Config
2025-03-14 Add USB device support with initialization and request handling
2025-03-15 Remove USB device implementation
2025-03-15 Remove USART1 and USB OTG FS support from HAL configuration and interrupt handlers
2025-03-15 Refactor CMakeLists.txt to remove USB device support and add ADC source files
2025-03-15 Refactor UI and Fader APIs to improve error handling and update function signatures
    [UI.h, fader.h]
2025-03-15 Refactor flash memory functions to return device_error_t for improved error handling
    [flash.h]
2025-03-15 Remove CLI prompt print statements and update include path for cli.h
2025-03-15 Refactor device handling and error management; add MIDI support and improve CLI initialization
    [device.c, device.h, device_def.h, main.c, main.h]
2025-03-15 Fix include paths and update CMakeLists for CLI
    [cli_fns.h, main.h]
2025-03-18 Add new hardware files for FaderBay project and KiCad schematics
    [1_P1.kicad_sch, 2_P2.kicad_sch, 4_P3.kicad_sch, FaderBay.eprj, ProPrj_FaderBay_2025-03-18.epro, ProPrj_FaderBay_2025-03-18.kicad_sch, Schematic.kicad_pcb, Schematic.kicad_sch]
2025-03-21 Schematic updates
    [Faderbay.kicad_pcb, Faderbay.kicad_sch]
2025-04-27 Kicad project, gerbers and BOM uploaded
    [1_P1.kicad_sch, 2_P2.kicad_sch, 4_P3.kicad_sch, FaderBay.eprj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]
2025-05-29 Uploaded schematics
2025-09-25 Uploaded docs from drive
    [faderbay.xlsx]
2026-05-17 Add firmware source (STM32F405, NanoLog submodule)
2026-05-17 Update hardware: KiCad, Gerbers, BOM, new schematic variants
    [Faderbay.dsn, Faderbay.kicad_pcb, Faderbay_MidiDin5.kicad_sch, pta6043-2x10cixxxx.stp]
2026-05-17 Add Gemini image, remove root BOM/CSV/scripts
    [Faderbay.csv]
2026-05-19 Implement firmware resource managers, drivers and scheduler integration
2026-05-19 Implement fader driver with MUX channel scanning
2026-05-19 Add display driver API declarations
2026-05-23 Implement application modules, config and device init
2026-05-23 Add NanoLog instrumentation and bug fixes to drivers and resource managers
2026-05-23 Wire NanoLog UART backend via submodule update
2026-05-23 Update KiCad project view settings
    [Faderbay.kicad_pcb]
2026-05-29 Add .gitattributes, extract syscalls stub, tighten build flags
    [config.c]
2026-05-29 Expand KiCad .gitignore, untrack generated files, update schematic date
    [Faderbay.dsn, Faderbay.kicad_sch, Faderbay_BOM.csv, pta6043-2x10cixxxx.stp]
2026-05-29 Fix .gitignore to cover KiCad *-bak files
2026-05-29 Refactor fader subsystem: ADC DMA event-driven, IIR filter, MUX settling
2026-05-29 Refactor button driver: state machine, event queue, long-press and double-click
2026-05-29 Improve encoder driver: detent normalisation, jitter absorption, velocity acceleration
2026-05-29 PCB update
2026-05-29 Update NanoLog submodule to current HEAD
2026-05-29 Remove ST vendor libraries from tracking, add gitignore and gitattributes
    HAL, CMSIS and USB Middleware are regenerated by STM32CubeIDE and do not
    belong in version control. Add .gitattributes to normalise line endings to LF.
2026-05-29 Enable DMA for ADC1 and SPI1, switch SPI transmit to DMA
    CubeMX regeneration adding DMA2 init (streams 0 and 3), IRQ handlers, and
    linking DMA handles to ADC1 and SPI1. ADC sampling extended to 480 cycles for
    MUX settling. SPI prescaler set to /128 for display stability. SPI_SendBuffer
    switched to HAL_SPI_Transmit_DMA with busy-wait polling.
    [main.c]
2026-05-29 Fix display driver CS polarity and add init delay, test pattern
    CS was driven inverted (0=high, 1=low). Add 100ms delay before u8g2 init to
    allow display power-on settling. Add DisplayDriver_TestPattern() for hardware
    bringup debugging.
2026-05-29 Fader driver: replace DWT cycle counter settle delay with NOP loop
2026-05-29 Wrap verbose debug logs in compile-time guards
    FADER_CTRL_DEBUG and MIDI_CTRL_DEBUG flags disable noisy per-sample logging
    in production builds.
2026-05-29 Remove old exported hardware files from repo root
    BOM, position file and schematic exports are now managed through KiCad.
    [Faderbay_BOM.csv, Faderbay_position.csv]
2026-05-31 Add UART5 TX DMA; switch button GPIOs from EXTI to polled input
2026-05-31 Button driver: fix active-low polarity, add boot warmup guard; raise ADC cap
    [config.h]
2026-05-31 Fader driver: prime IIR filter on boot to suppress spurious MIDI
2026-05-31 Display driver: remove test pattern scaffolding
2026-06-02 UART: add non-blocking DMA TX ring buffer
2026-06-02 MIDI driver: switch TX to DMA ring
2026-06-02 Add Midi tools
    [midi sample2.csv]
2026-06-11 Project backup
    [Faderbay-B_Cu.gbr, Faderbay-B_Mask.gbr, Faderbay-B_Paste.gbr, Faderbay-B_Silkscreen.gbr, Faderbay-Edge_Cuts.gbr, Faderbay-F_Cu.gbr, Faderbay-F_Mask.gbr, Faderbay-F_Paste.gbr]
